TechN3o/ContRoller/Schematic_contRollerV2.1.pdf

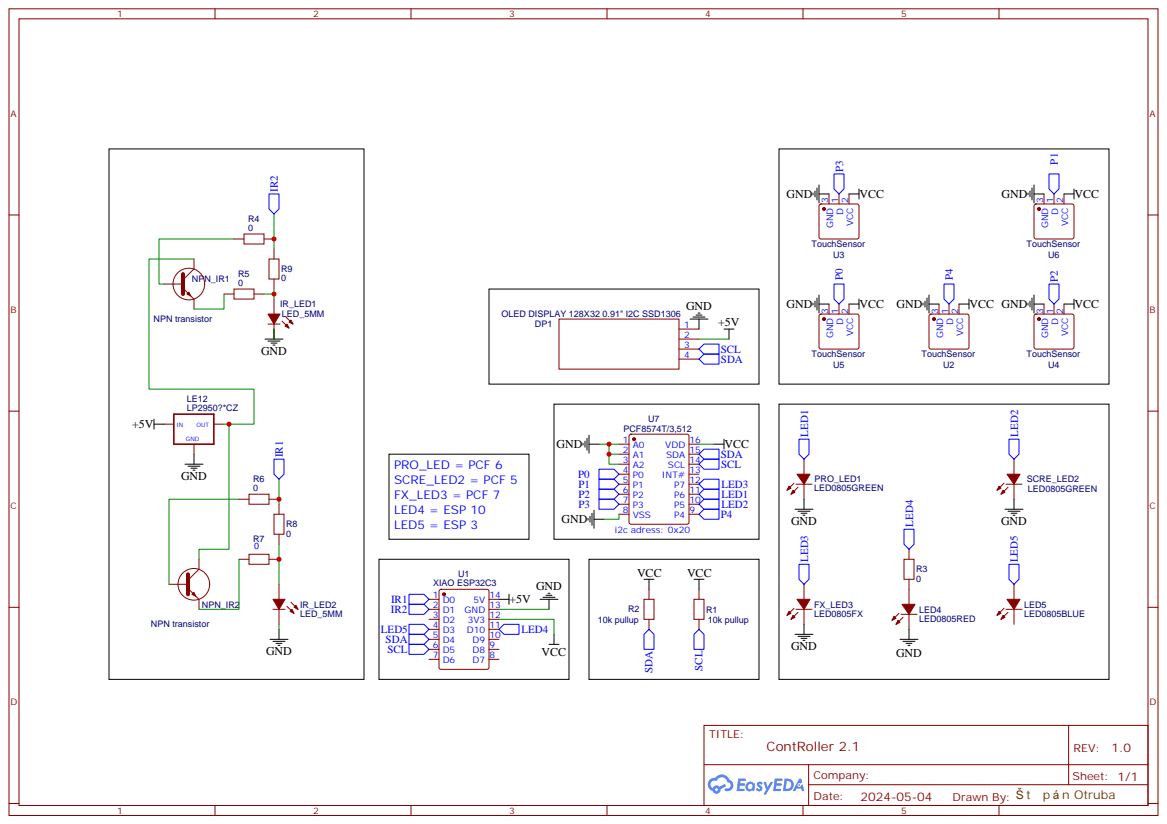
[picture p12: page 1]

P5 10 P6 11 P7 12 INT# 13 SCL 14 SDA 15 VDD 16
