TechN3o/ContRoller/(notices)

Notices in the files:
src/PinDefinitionsAndMore.h:
Arduino-IRremote is free software: you can redistribute it and/or modify
it under the terms of the GNU General Public License as published by
the Free Software Foundation, either version 3 of the License, or
(at your option) any later version.
along with this program. If not, see <http://www.gnu.org/licenses/gpl.html>.
